versioduo/beat-4/hardware/README.md

# beat-4
🧲 4 Channel Solenoid Controller

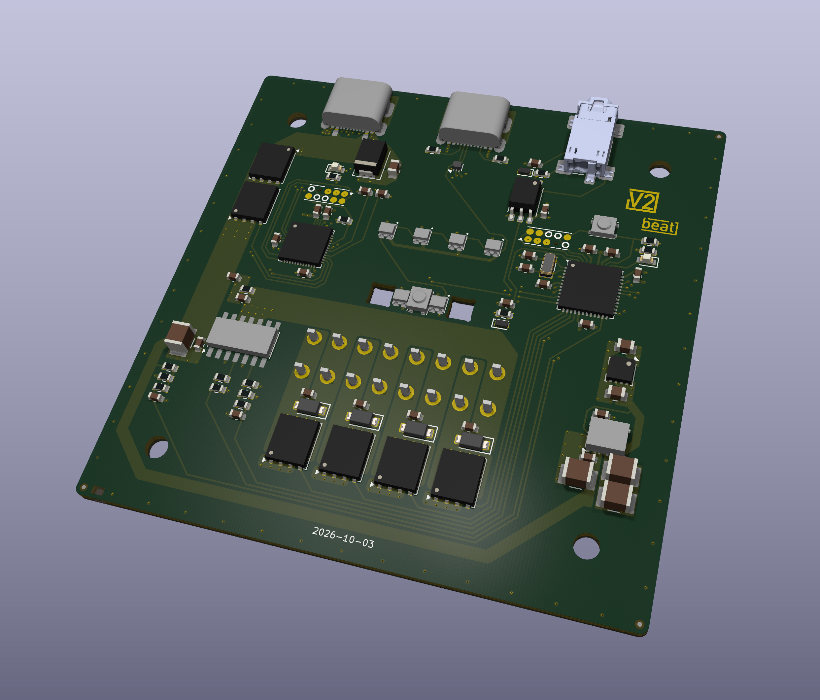
[picture p1: hardware/beat-4-board.png]
board


## Schematic
[PDF](beat-4.pdf)

## Bill Of Materials
[Interactive BOM](https://versioduo.com/view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)
