versioduo/beat-4/hardware/beat-4.pdf

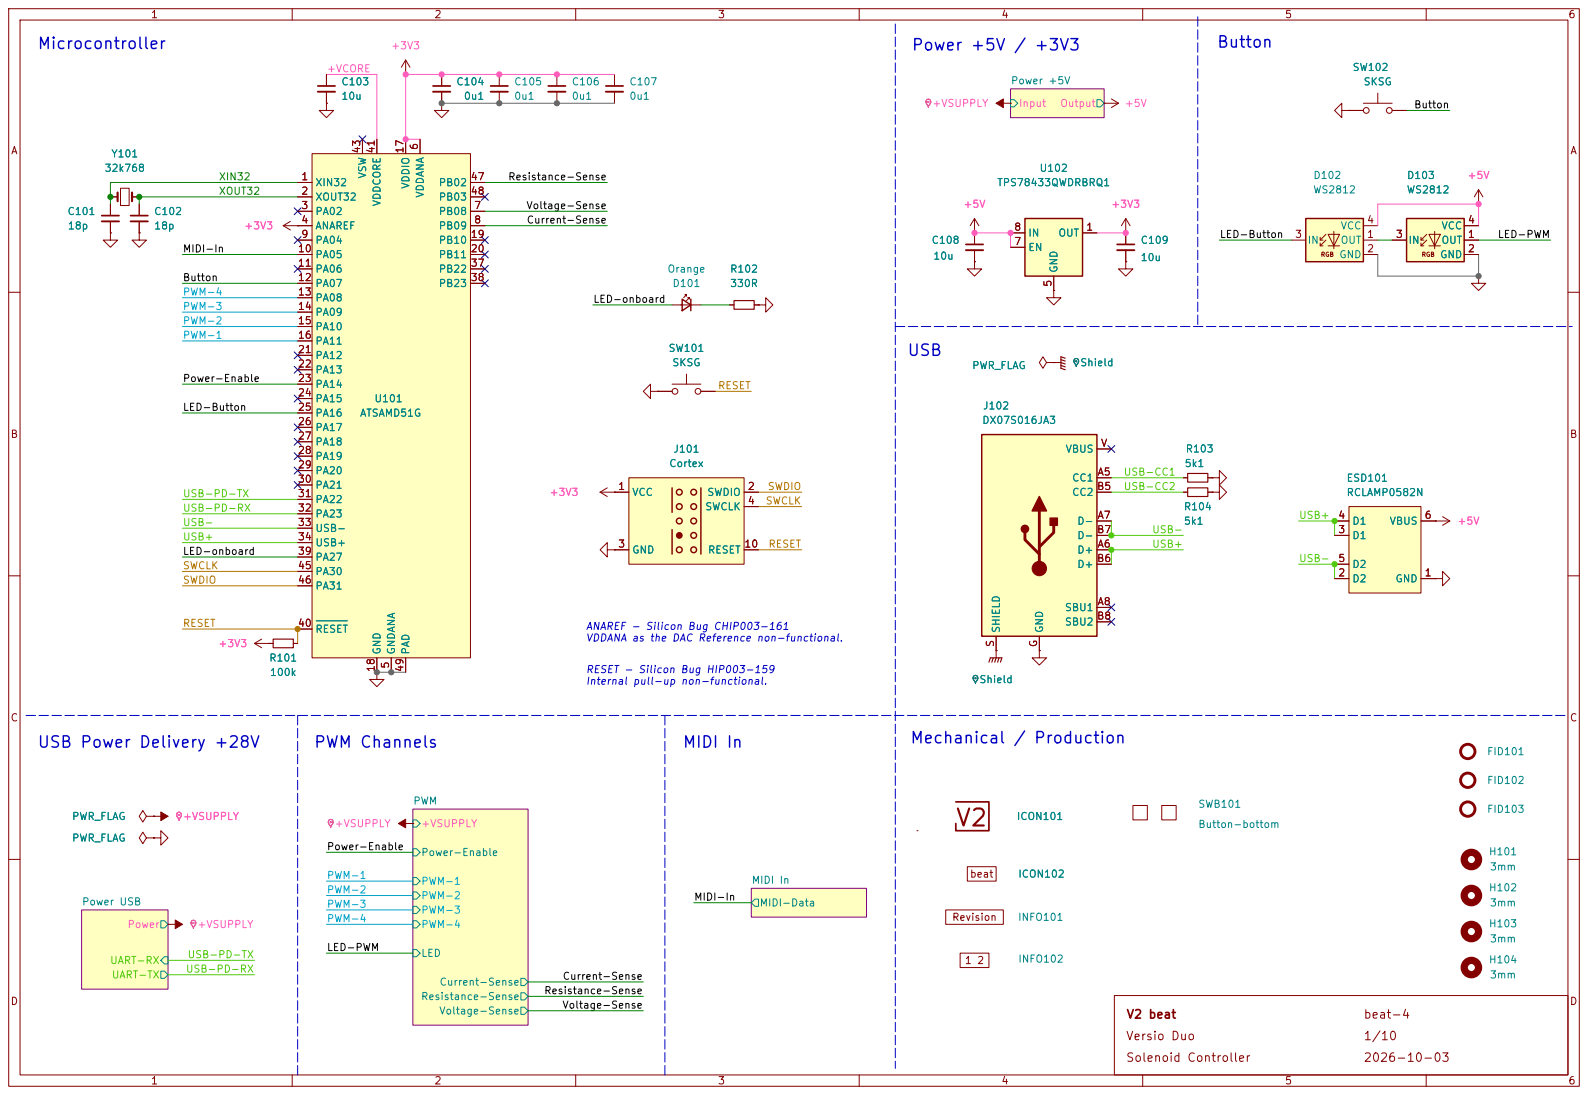
[picture p2: page 1]

FID103 +3V3 C102
LED-Button PWM-1 PWM-4

ANAREF - Silicon Bug CHIP003-161
VDDANA as the DAC Reference non-functional. RESET - Silicon Bug HIP003-159
Voltage-Sense Power-Enable +VSUPPLY PWM

PWM-1 PWM-2 PWM-3 PWM-4 Current-Sense Resistance-Sense

Power UART-RX UART-TX Power USB

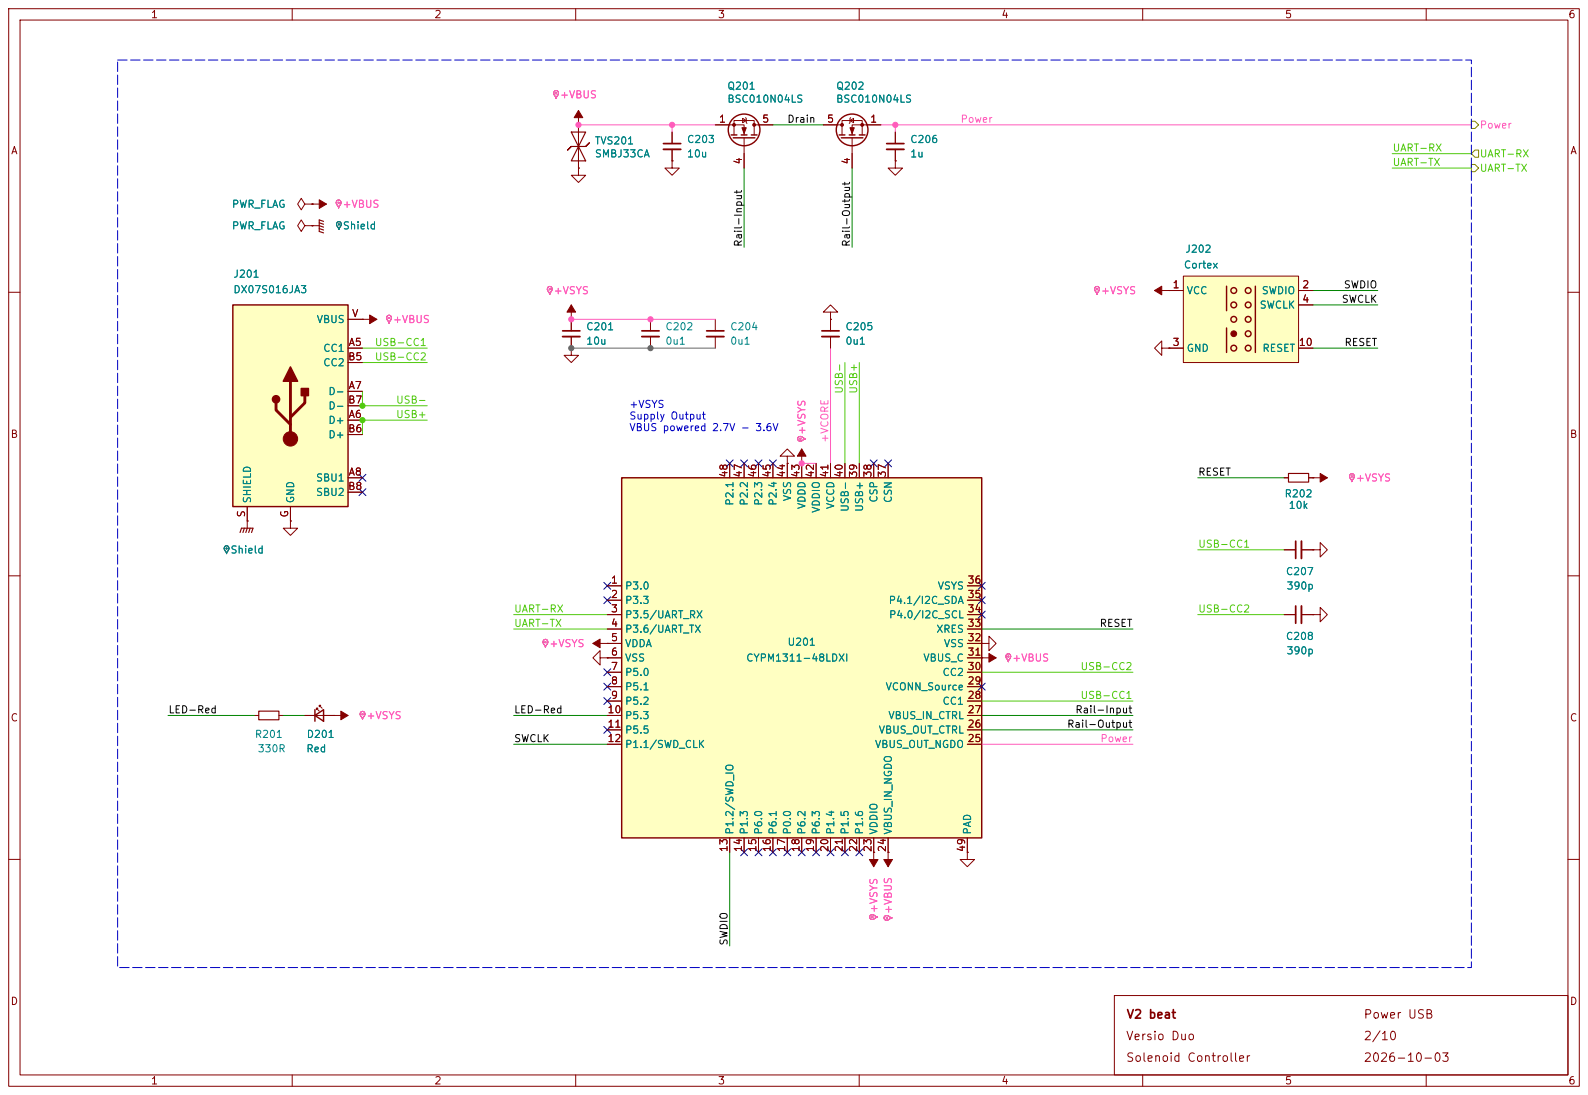
[picture p3: page 2]

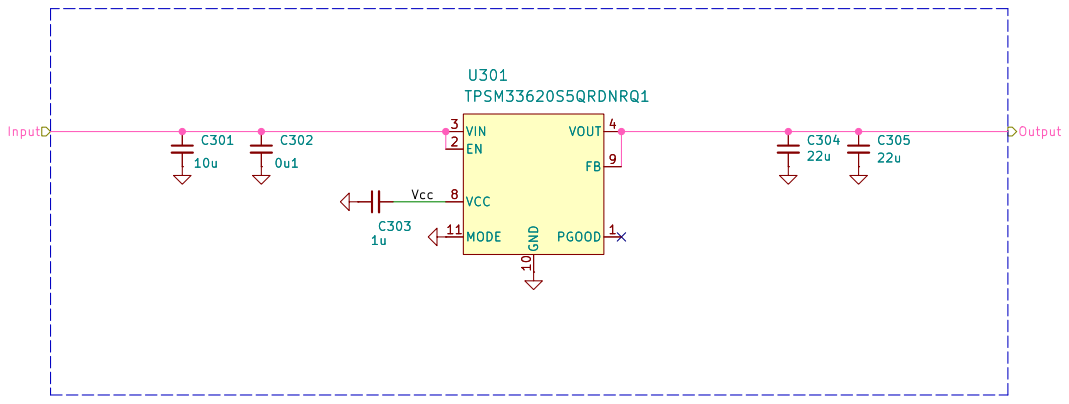
[picture p4: page 3]

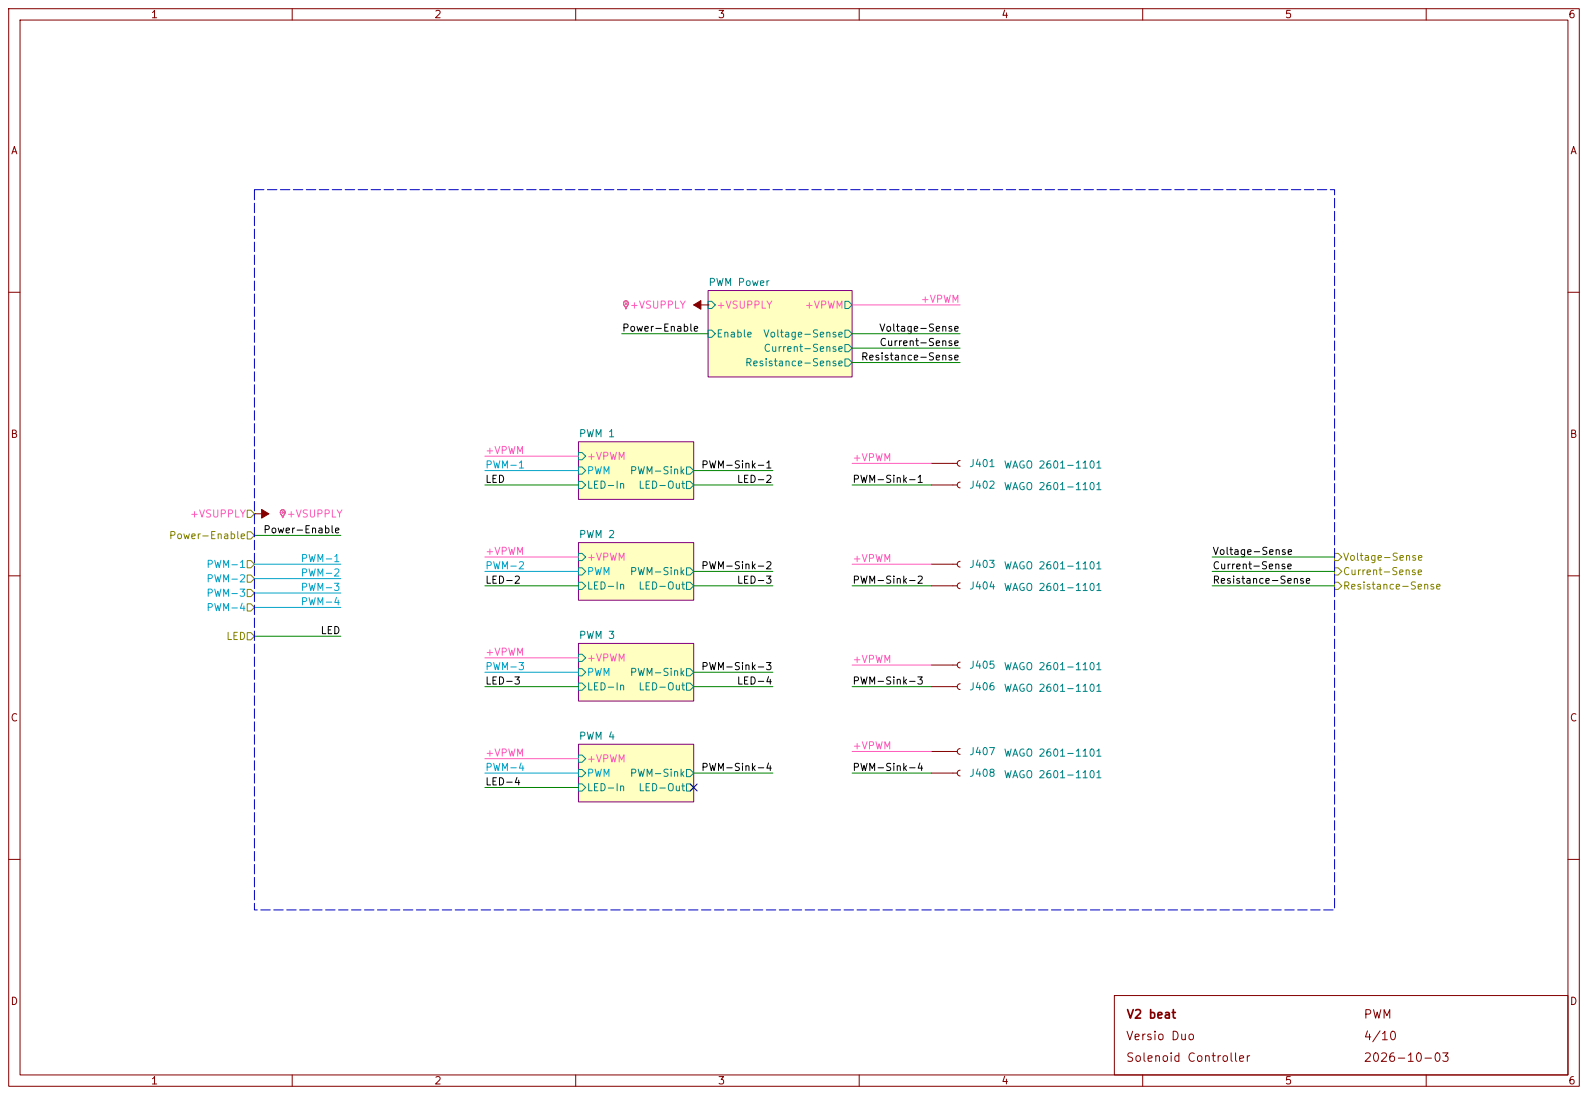
[picture p5: page 4]

Voltage-Sense PWM-Sink-2 Power-Enable

Current-Sense Resistance-Sense

LED-In LED-Out +VPWM
PWM-Sink PWM 2 PWM

Voltage-Sense Current-Sense Resistance-Sense +VPWM +VPWM +VPWM

PWM-Sink PWM 3 PWM

PWM-Sink-2 PWM-Sink-3

PWM

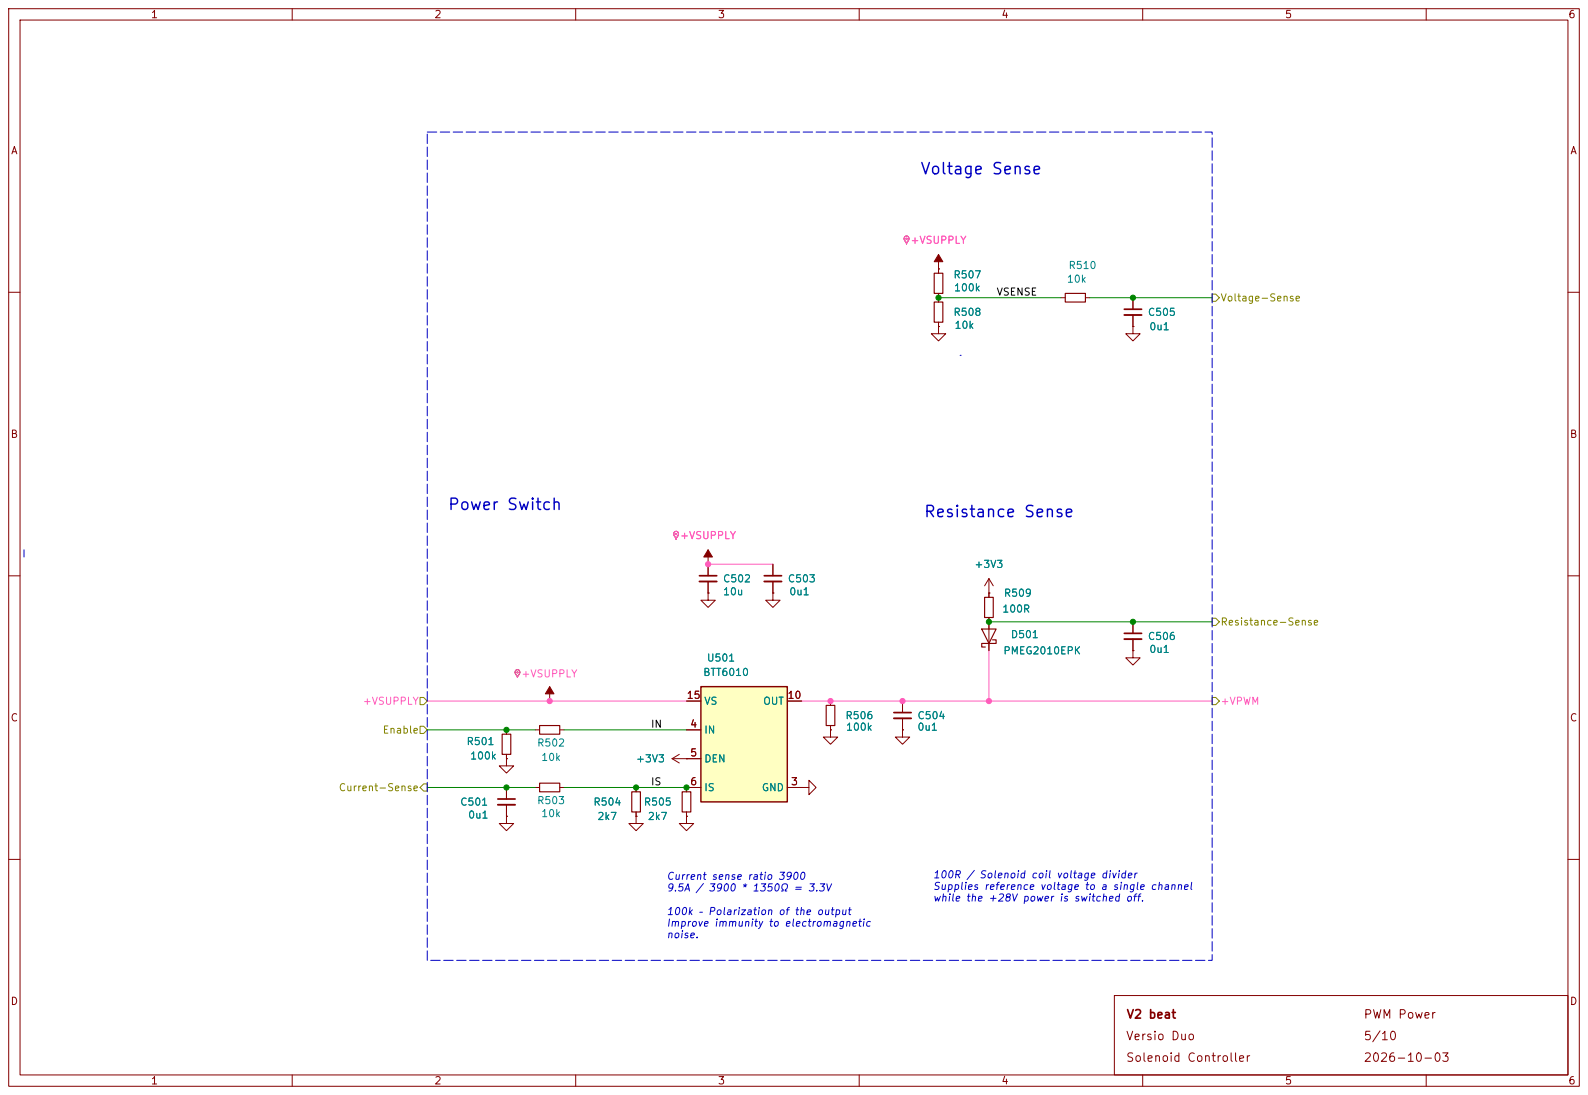
[picture p6: page 5]

Improve immunity to electromagnetic noise. Power Switch

100R / Solenoid coil voltage divider Supplies reference voltage to a single channel while the +28V power is switched off. Resistance Sense

Resistance-Sense Current-Sense Enable +VSUPPLY

Current sense ratio 3900
9.5A / 3900 * 1350Ω = 3.3V 100k – Polarization of the output

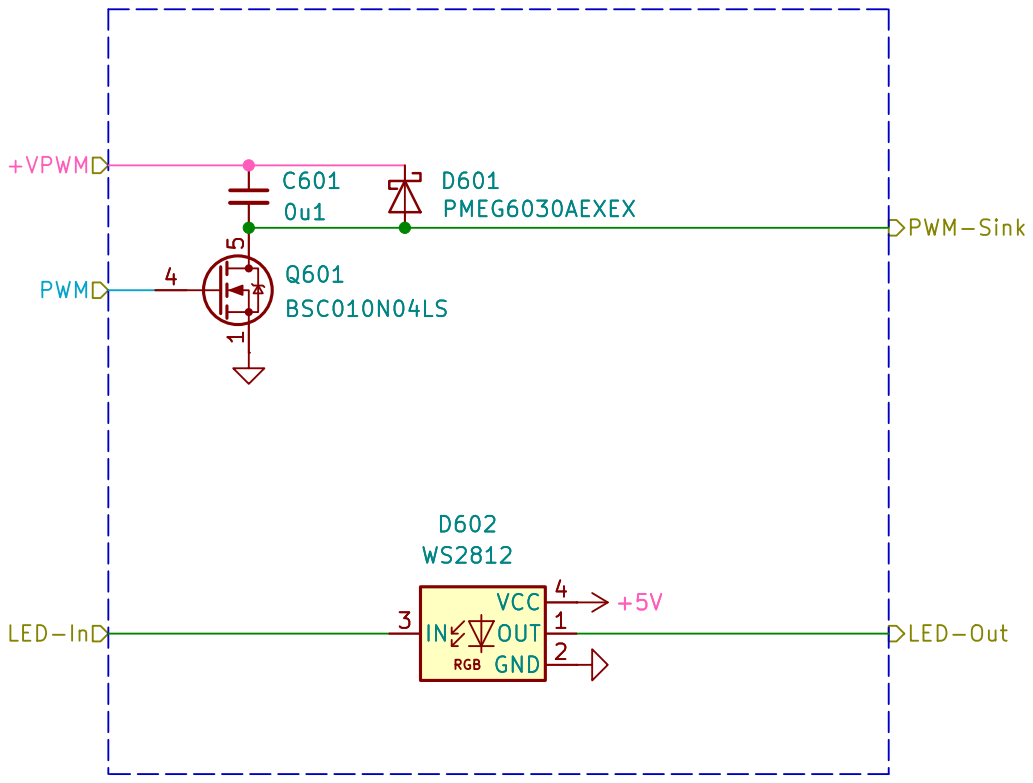
[picture p7: page 6]

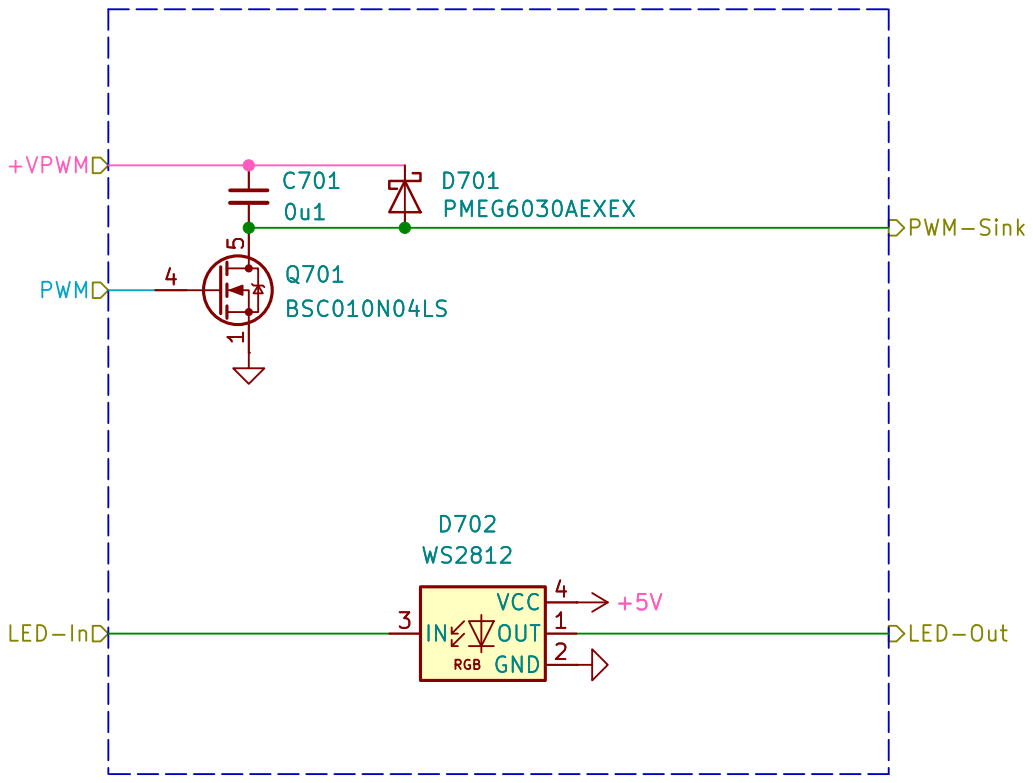
[picture p8: page 7]

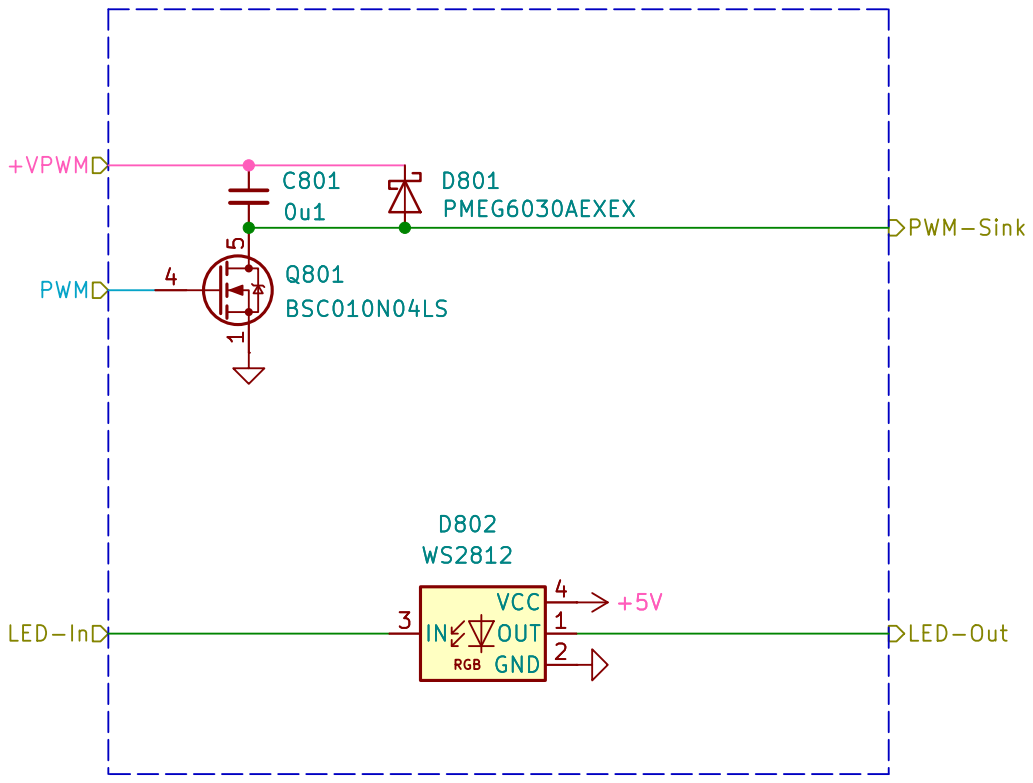
[picture p9: page 8]

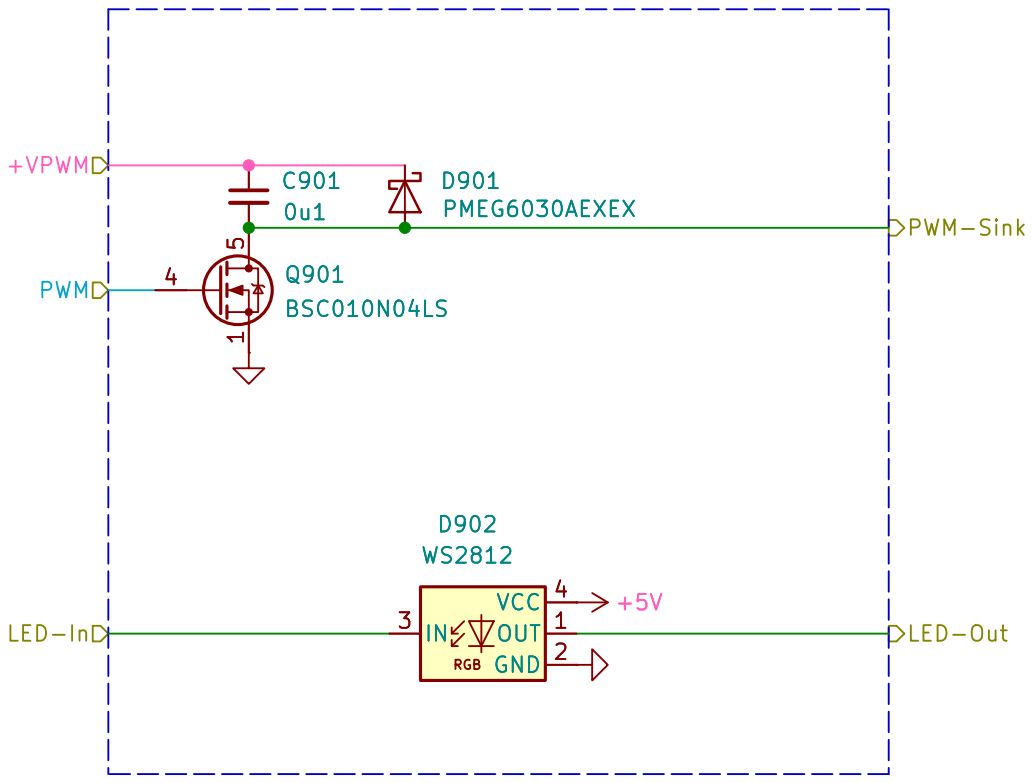
[picture p10: page 9]

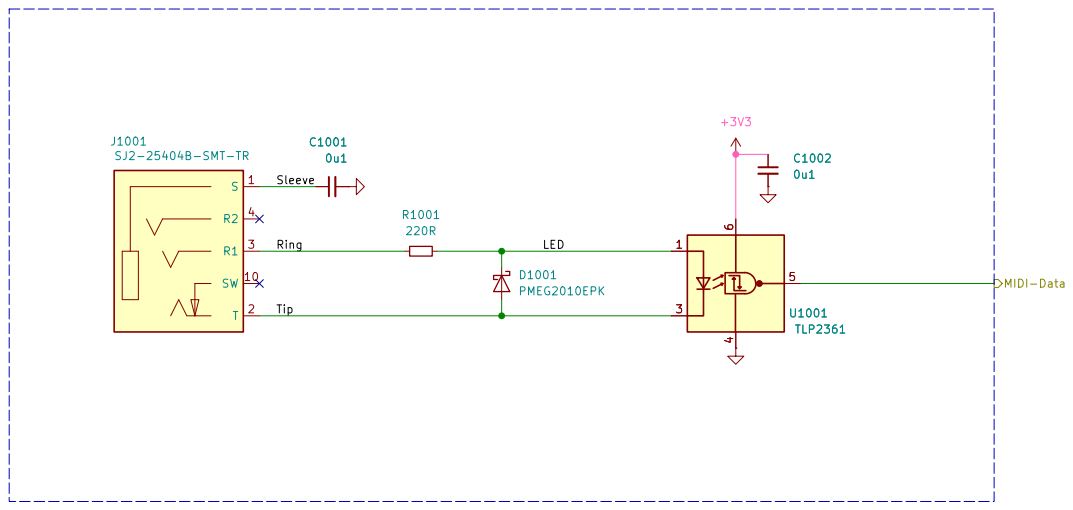
[picture p11: page 10]
