versioduo/beat-4/hardware/beat-4.kicad_pcb

## KiCad design hardware/beat-4.kicad_pcb (2026-10-19)

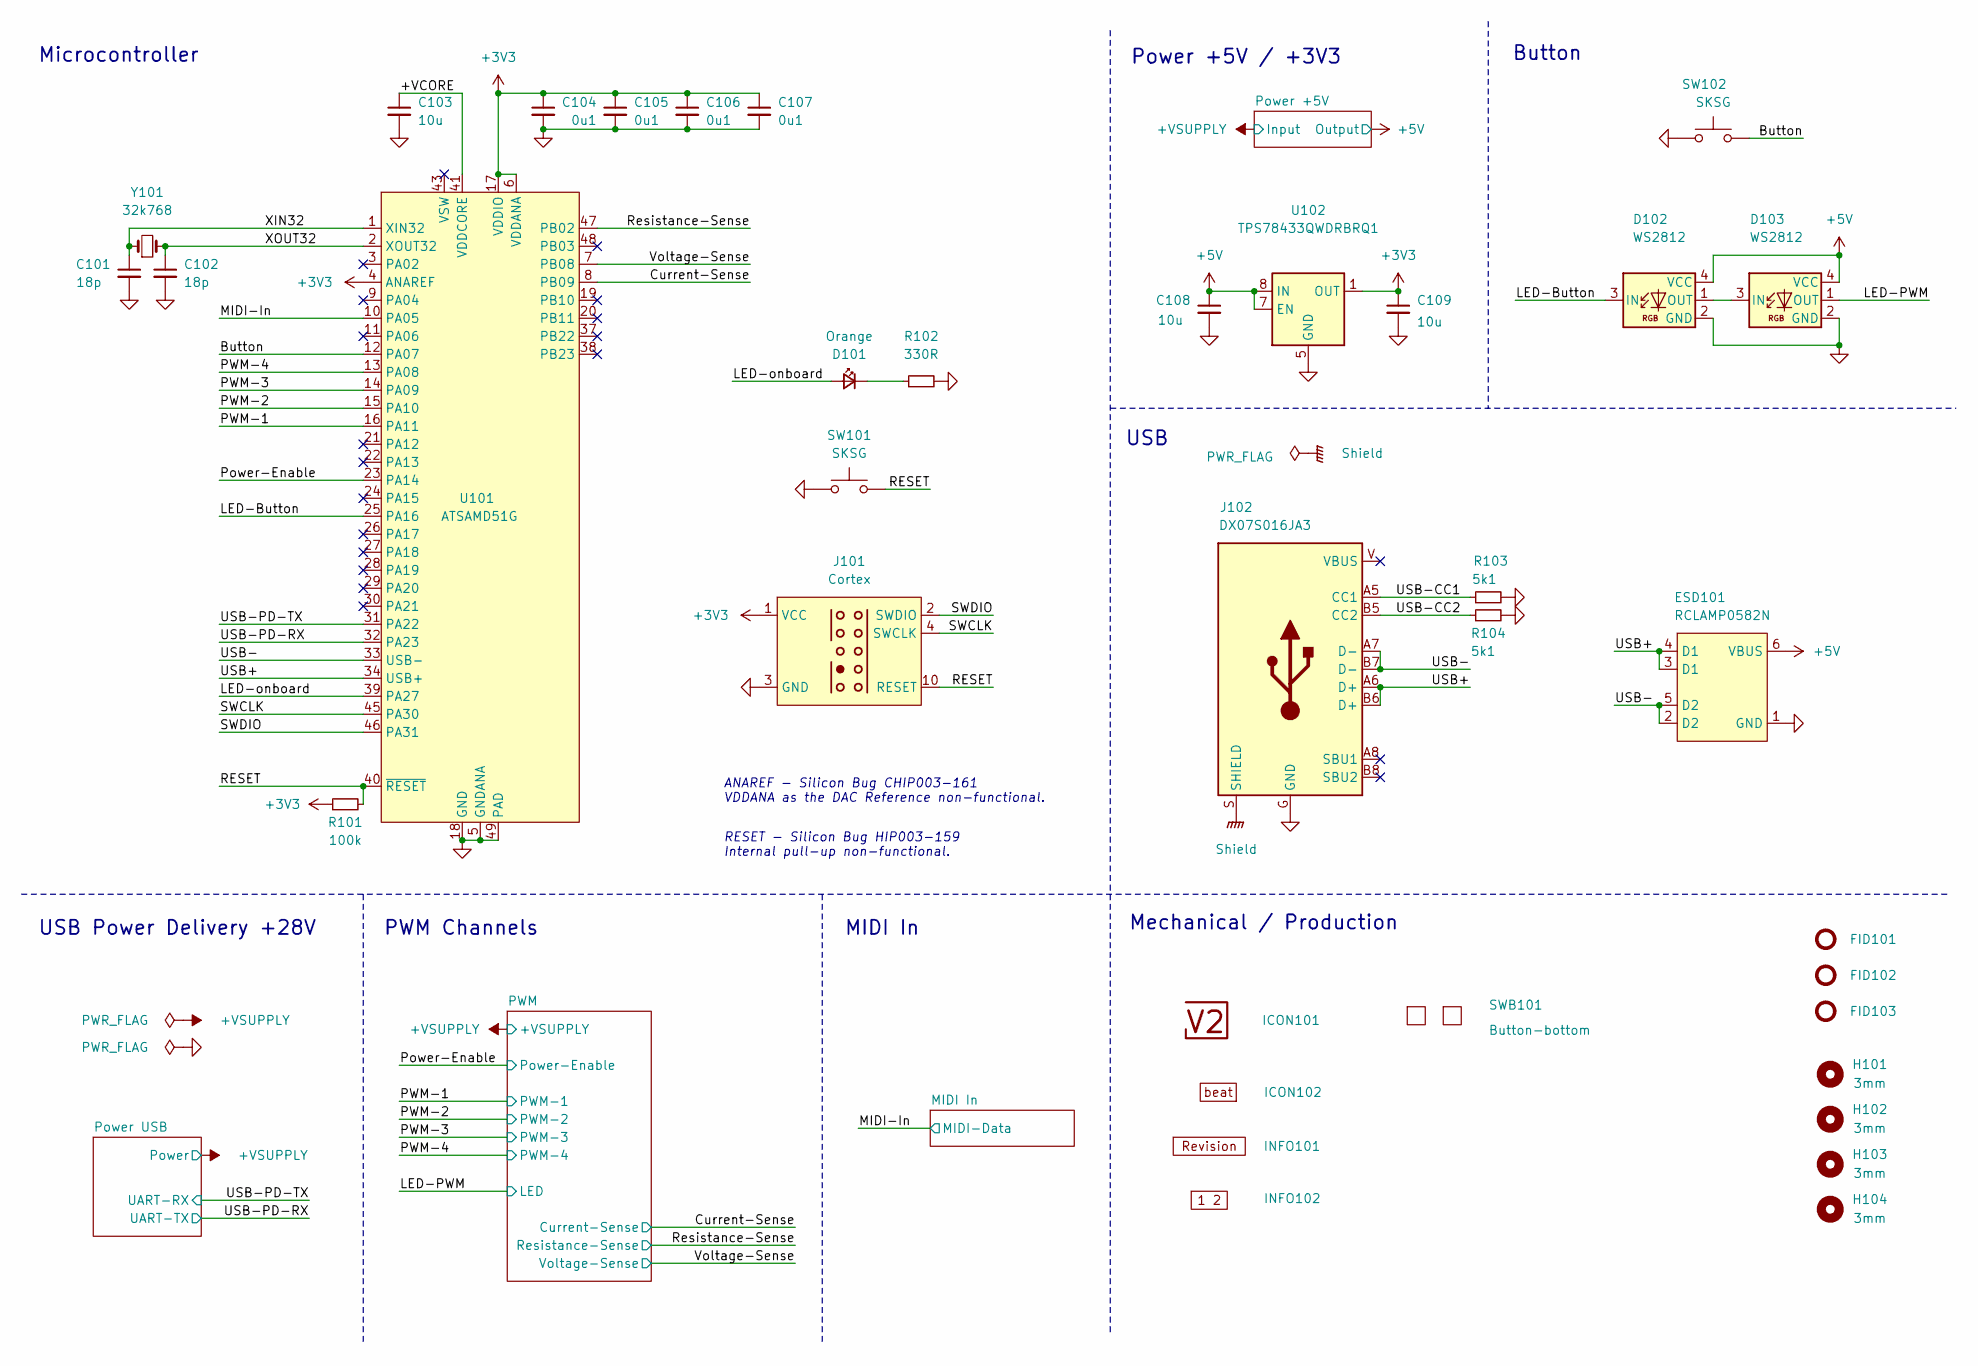
[picture p12: schematic beat-4.kicad_sch, V2 beat]

Parts:
C101, C102: 18p; C_1608; Rating 50V; Mouser 810-CGA3E2C0G1H180J
C103: 10u; C_1608; Rating 10V; Mouser 810-C1608X6S1A106M
C104, C105, C106, C107: 0u1; C_1608; Rating 50V; Mouser 810-CGA3E2X7R1H104MA
C108, C109: 10u; C_2012; Rating 25V; Mouser 810-C2012X5R1E106K
D101: Orange; LED_1608; Rating 605nm; Mouser 755-SML-D12D1WT86
D102, D103: WS2812; WS2812-2020; Rating 15mA; LCSC C965555
ESD101: RCLAMP0582N; SLP1210N6; Rating 20kV; Mouser 947-RCLAMP0582N.TCT
FID101, FID102, FID103: Fiducial_Paste; Fiducial_0.5mm_Mask1mm_Paste
H101, H102, H103, H104: 3mm; MountingHole_3mm
ICON101: V2-logo; Logo_Small
ICON102: Board_axis; Board_beat_Small
INFO101: Revision
INFO102: Layer_Numbers-4
J101: Cortex
J102: DX07S016JA3; JAE_DX07S016JA3; Rating USB2.0; Mouser 656-DX07S016JA3R1500
R101: 100k; R_1608; Rating 100mW; Mouser 71-CRCW0603100KFKEAC
R102: 330R; R_1608; Rating 100mW; Mouser 71-CRCW0603330RFKEAC
R103, R104: 5k1; R_1608; Rating 100mW; Mouser 71-CRCW06035K10FKEAC
SW101, SW102: SKSG; Rating 1.6N; Mouser 688-SKSGACE010
SWB101: Button-bottom; PCB_Button-bottom
U101: ATSAMD51G; QFN-48-1EP_7x7mm_P0.5mm_EP5.45x5.45mm_ThermalVias; Rating Cortex-M4F; Mouser 556-ATSAMD51G19AMU
U102: TPS78433QWDRBRQ1; VSON-8-1_3x3mm_P0.65_EP1.65x2.4mm; Rating 300mA; Mouser 595-TPS78433QWDRBRQ1
Y101: 32k768; Crystal_SMD_3215-2Pin_3.2x1.5mm; Rating 10ppm; Mouser 815-ABS0716632.768KT

Connections:
+3V3: C104.1, C105.1, C106.1, C107.1, C109.1, J101.1 (VCC), R101.1, U101.4 (ANAREF), U101.6 (VDDANA), U101.17 (VDDIO), U101.36 (VDDIO), U101.44 (VDDIO), U102.1 (OUT); also elsewhere on the board
+5V: C108.1, D102.4 (VCC), D103.4 (VCC), ESD101.6 (VBUS), U102.6 (EN), U102.7 (EN), U102.8 (IN); also elsewhere on the board
/+VCORE: C103.1, U101.41 (VDDCORE)
/Button: SW102.2, U101.12 (PA07)
/Current-Sense: U101.8 (PB09); also elsewhere on the board
/LED-Button: D102.3 (IN), U101.25 (PA16)
/LED-PWM: D103.1 (OUT); also elsewhere on the board
/LED-onboard: D101.2 (A), U101.39 (PA27)
/MIDI-In: U101.10 (PA05); also elsewhere on the board
/PWM-1: U101.16 (PA11); also elsewhere on the board
/PWM-2: U101.15 (PA10); also elsewhere on the board
/PWM-3: U101.14 (PA09); also elsewhere on the board
/PWM-4: U101.13 (PA08); also elsewhere on the board
/Power-Enable: U101.23 (PA14); also elsewhere on the board
/RESET: J101.10 (RESET), R101.2, SW101.2, U101.40 (~RESET)
/Resistance-Sense: U101.47 (PB02); also elsewhere on the board
/SWCLK: J101.4 (SWCLK), U101.45 (PA30)
/SWDIO: J101.2 (SWDIO), U101.46 (PA31)
/Shield: J102.S (SHIELD)
/USB+: ESD101.3 (D1), ESD101.4 (D1), J102.A6 (D+), J102.B6 (D+), U101.34 (USB+)
/USB-: ESD101.2 (D2), ESD101.5 (D2), J102.A7 (D-), J102.B7 (D-), U101.33 (USB-)
/USB-CC1: J102.A5 (CC1), R103.1
/USB-CC2: J102.B5 (CC2), R104.1
/USB-PD-RX: U101.32 (PA23); also elsewhere on the board
/USB-PD-TX: U101.31 (PA22); also elsewhere on the board
/Voltage-Sense: U101.7 (PB08); also elsewhere on the board
/XIN32: C101.1, U101.1 (XIN32), Y101.1
/XOUT32: C102.1, U101.2 (XOUT32), Y101.2
GND: C101.2, C102.2, C103.2, C104.2, C105.2, C106.2, C107.2, C108.2, C109.2, D102.2 (GND), D103.2 (GND), ESD101.1 (GND), J101.3 (GND), J101.5 (GND), J102.G (GND), R102.2, R103.2, R104.2, SW101.1, SW102.1, U101.5 (GNDANA), U101.18 (GND), U101.35 (GND), U101.42 (GND), U101.49 (PAD), U102.5 (GND), U102.9 (GND); also elsewhere on the board
unnamed: D101.1 (K), R102.1
unnamed: D102.1 (OUT), D103.3 (IN)

Notes on the sheet:
ANAREF -  Silicon Bug CHIP003-161 VDDANA as the DAC Reference non-functional.
PWM Channels
RESET -  Silicon Bug HIP003-159 Internal pull-up non-functional.
Button
Power +5V / +3V3
Mechanical / Production
Microcontroller
MIDI In
USB
USB Power Delivery +28V

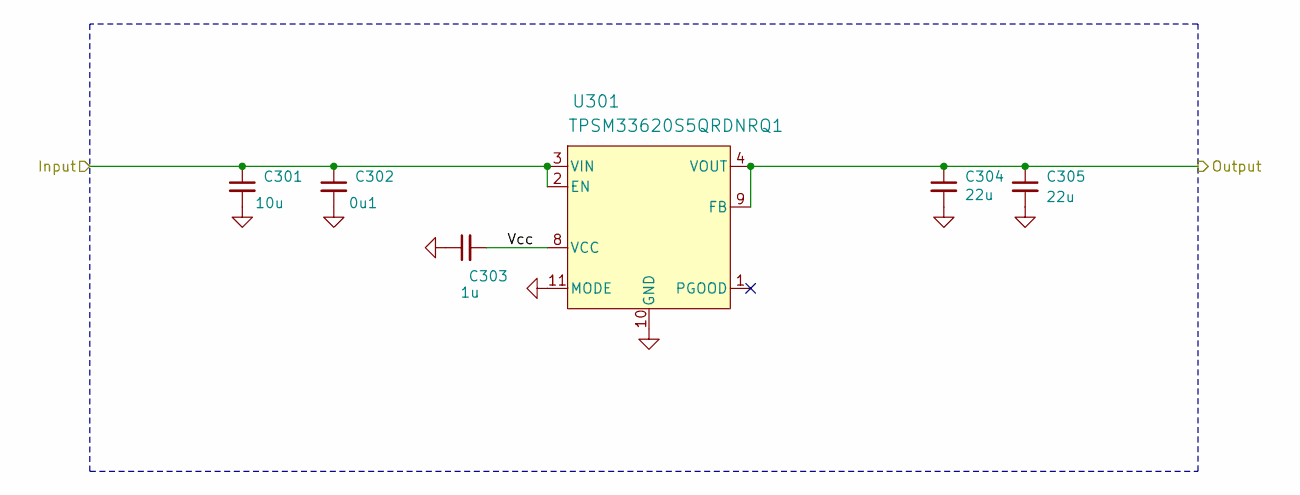
[picture p13: schematic Power-DCDC.kicad_sch, V2 beat]

Parts:
C301: 10u; C_3225; Rating 50V; Mouser 810-CNC6P1X7R1H106K2
C302: 0u1; C_1608; Rating 50V; Mouser 810-CGA3E2X7R1H104MA
C303: 1u; C_1608; Rating 50V; Mouser 810-CGA3E3X7R1H105K0
C304, C305: 22u; C_3225; Rating 25V; Mouser 810-CGA6P3X7R1E226M5
U301: TPSM33620S5QRDNRQ1; QFN-11; Rating 2A; Mouser 595-SM33620S5QRDNRQ1

Connections:
+5V: C304.1, C305.1, U301.4 (VOUT), U301.9 (FB); also elsewhere on the board
/+VSUPPLY: C301.1, C302.1, U301.2 (EN), U301.3 (VIN); also elsewhere on the board
/Power +5V/Vcc: C303.2, U301.8 (VCC)
GND: C301.2, C302.2, C303.1, C304.2, C305.2, U301.10 (GND), U301.11 (MODE); also elsewhere on the board

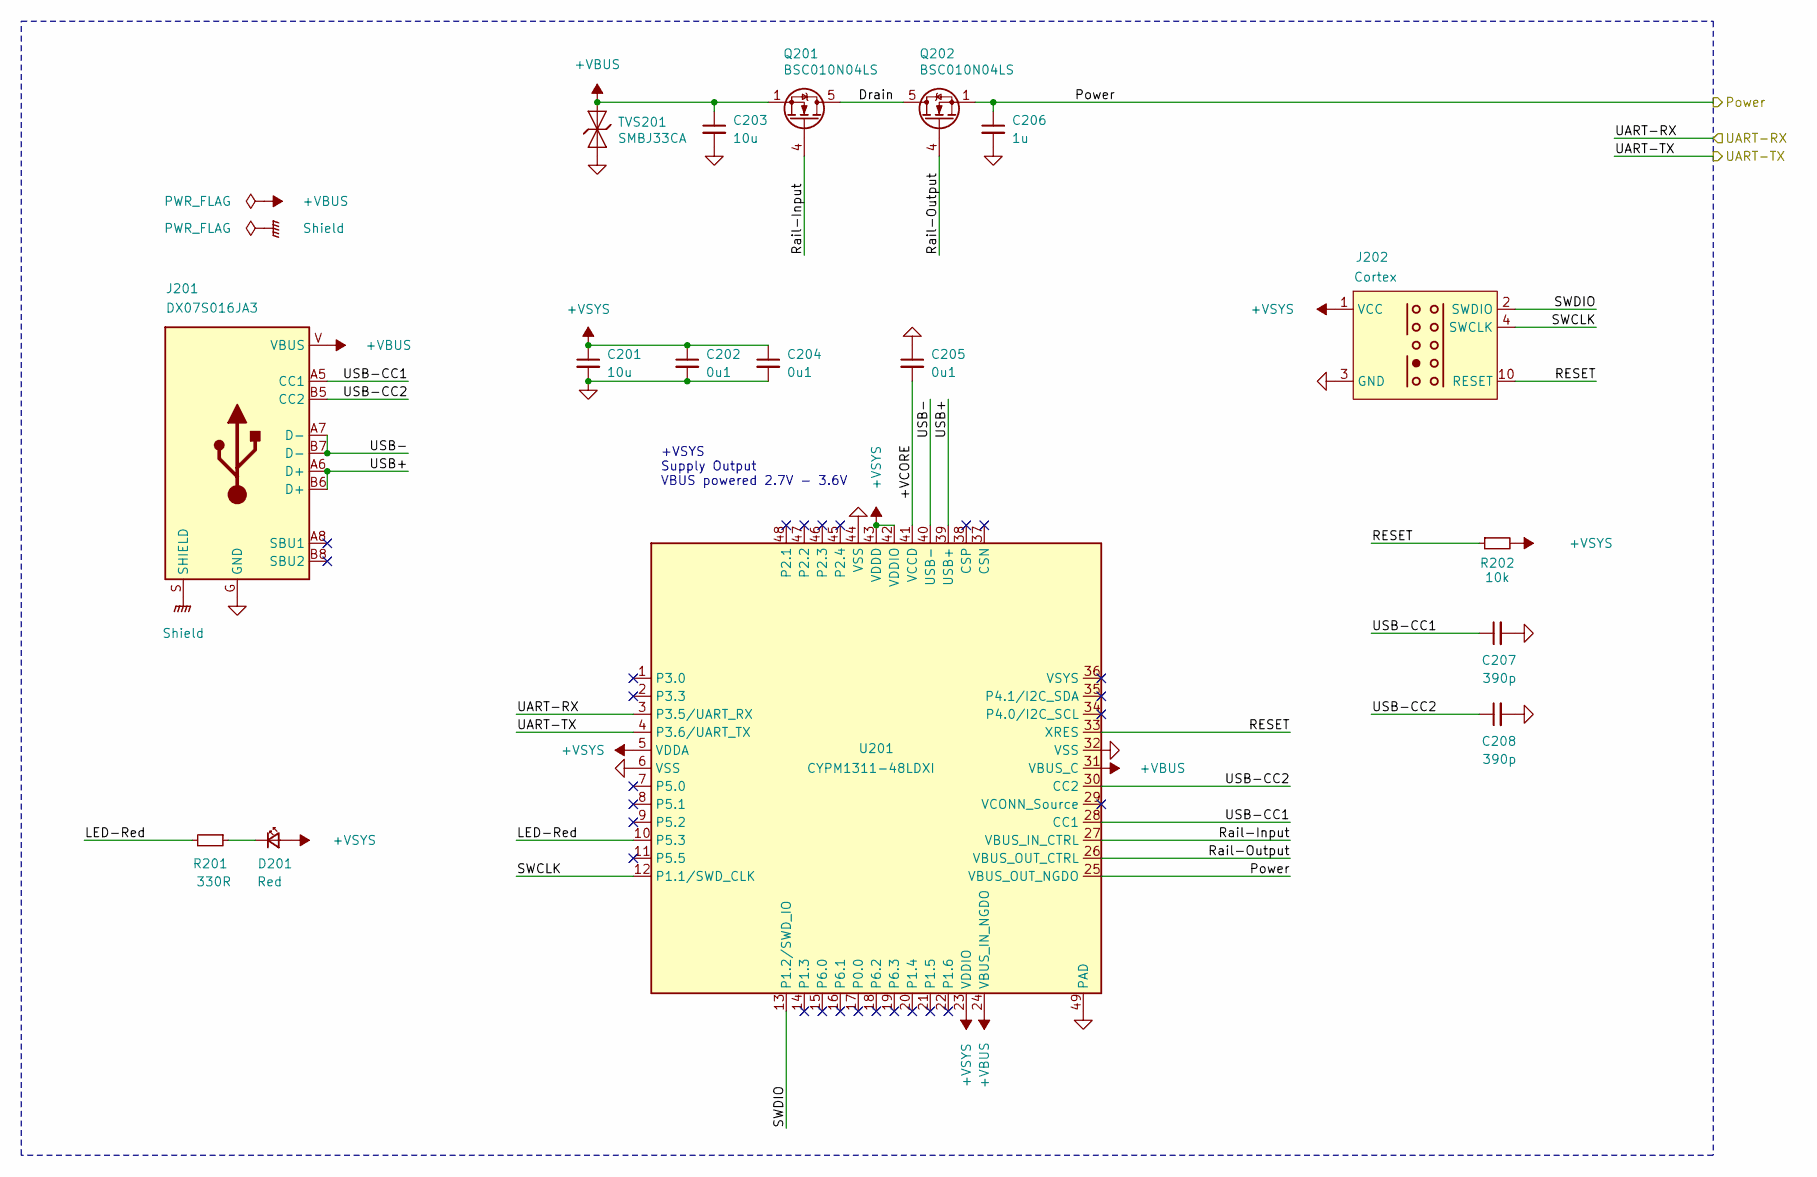
[picture p14: schematic Power-USB.kicad_sch, V2 beat]

Parts:
C201: 10u; C_1608; Rating 10V; Mouser 810-C1608X6S1A106M
C202, C204, C205: 0u1; C_1608; Rating 50V; Mouser 810-CGA3E2X7R1H104MA
C203: 10u; C_2012; Rating 25V; Mouser 810-C2012X5R1E106K
C206: 1u; C_1608; Rating 50V; Mouser 810-CGA3E3X7R1H105K0
C207, C208: 390p; C_1608; Rating 50V; Mouser 810-CGA3E2C0G1H391J
D201: Red; LED_1608; Rating 630nm; Mouser 755-SML-D12V1WT86
J201: DX07S016JA3; JAE_DX07S016JA3-PD; Rating USB2.0; Mouser 656-DX07S016JA3R1500
J202: Cortex
Q201, Q202: BSC010N04LS; TDSON-8-FL; Rating 40V; Mouser 726-BSC010N04LS
R201: 330R; R_1608; Rating 100mW; Mouser 71-CRCW0603330RFKEAC
R202: 10k; R_1608; Rating 100mW; Mouser 71-CRCW060310K0FKEAC
TVS201: SMBJ33CA; D_SMB; Rating 33V; Mouser 652-SMBJ33CA-Q
U201: CYPM1311-48LDXI; QFN-48-1EP_6x6mm_P0.4mm_EP4.6x4.6mm; Rating 28V; Mouser 727-CYPM1311-48LDXI

Connections:
/+VSUPPLY: C206.1, Q202.1 (S), U201.25 (VBUS_OUT_NGDO); also elsewhere on the board
/Power USB/+VBUS: C203.1, J201.V (VBUS), Q201.1 (S), TVS201.2 (A), U201.24 (VBUS_IN_NGDO), U201.31 (VBUS_C)
/Power USB/+VCORE: C205.2, U201.41 (VCCD)
/Power USB/+VSYS: C201.1, C202.1, C204.1, D201.2 (A), J202.1 (VCC), R202.2, U201.5 (VDDA), U201.23 (VDDIO), U201.42 (VDDIO), U201.43 (VDDD)
/Power USB/Drain: Q201.5 (D), Q202.5 (D)
/Power USB/LED-Red: R201.2, U201.10 (P5.3)
/Power USB/RESET: J202.10 (RESET), R202.1, U201.33 (XRES)
/Power USB/Rail-Input: Q201.4 (G), U201.27 (VBUS_IN_CTRL)
/Power USB/Rail-Output: Q202.4 (G), U201.26 (VBUS_OUT_CTRL)
/Power USB/SWCLK: J202.4 (SWCLK), U201.12 (P1.1/SWD_CLK)
/Power USB/SWDIO: J202.2 (SWDIO), U201.13 (P1.2/SWD_IO)
/Power USB/Shield: J201.S (SHIELD)
/Power USB/USB+: J201.A6 (D+), J201.B6 (D+), U201.39 (USB+)
/Power USB/USB-: J201.A7 (D-), J201.B7 (D-), U201.40 (USB-)
/Power USB/USB-CC1: C207.1, J201.A5 (CC1), U201.28 (CC1)
/Power USB/USB-CC2: C208.1, J201.B5 (CC2), U201.30 (CC2)
/USB-PD-RX: U201.4 (P3.6/UART_TX); also elsewhere on the board
/USB-PD-TX: U201.3 (P3.5/UART_RX); also elsewhere on the board
GND: C201.2, C202.2, C203.2, C204.2, C205.1, C206.2, C207.2, C208.2, J201.G (GND), J202.3 (GND), J202.5 (GND), TVS201.1 (K), U201.6 (VSS), U201.32 (VSS), U201.44 (VSS), U201.49 (PAD); also elsewhere on the board
unnamed: D201.1 (K), R201.1

Notes on the sheet:
+VSYS Supply Output VBUS powered 2.7V - 3.6V

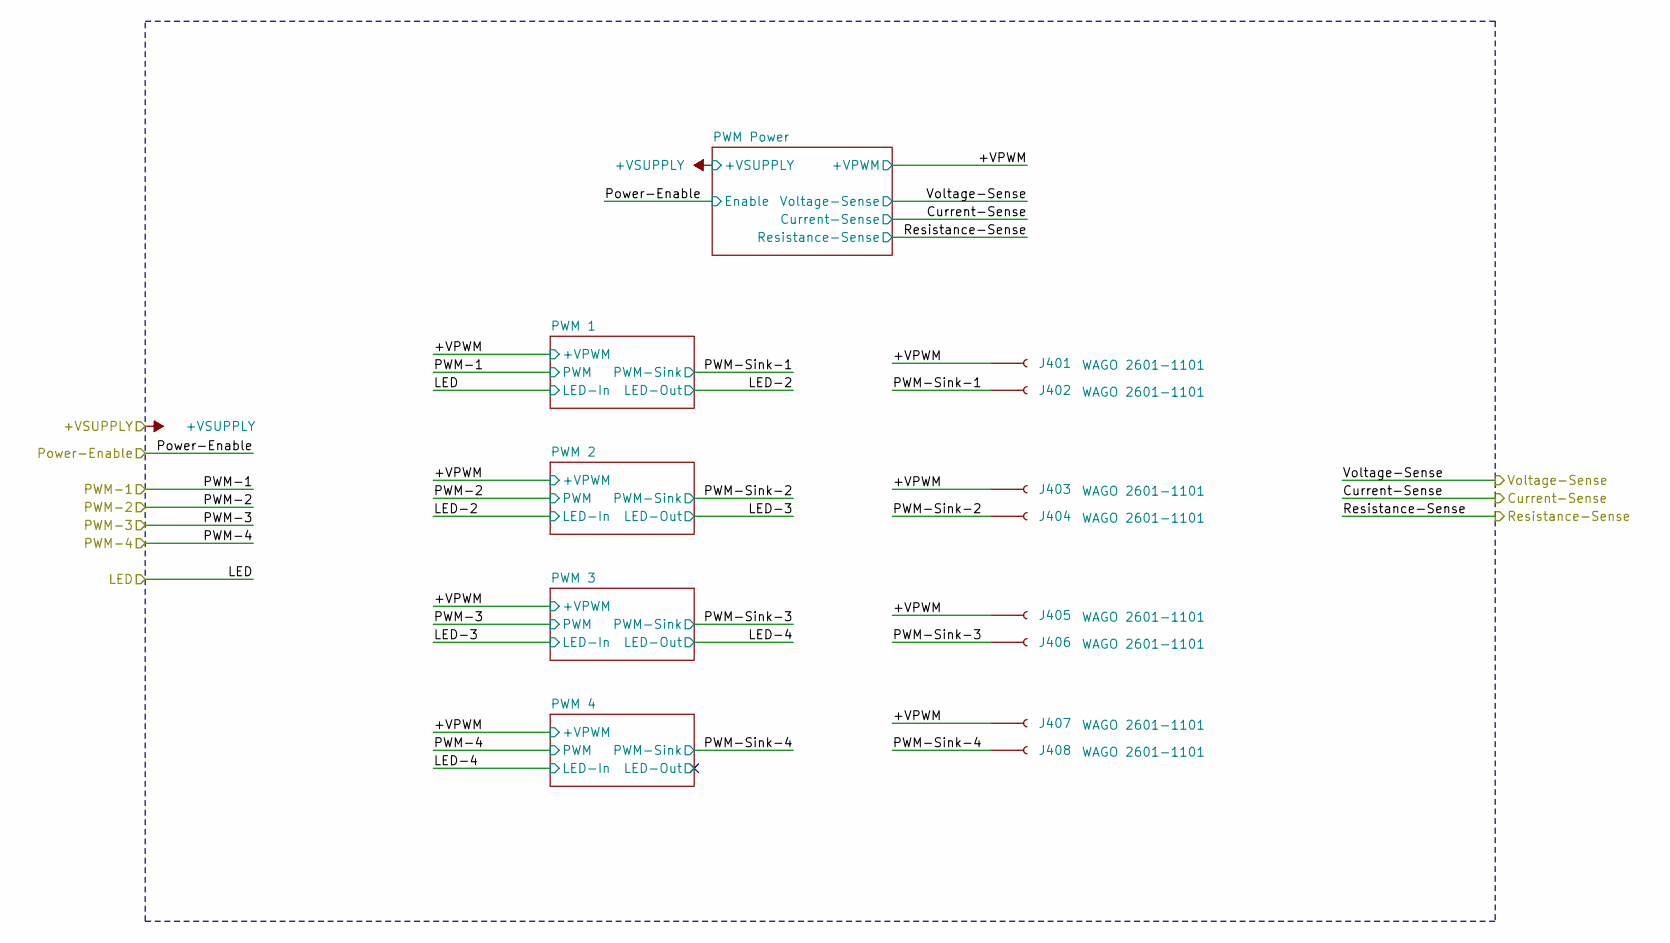
[picture p15: schematic PWM.kicad_sch, V2 beat]

Parts:
J401, J402, J403, J404, J405, J406, J407, J408: WAGO 2601-1101; 2601-1101; Rating 17.5A

Connections:
/PWM/+VPWM: J401.1, J403.1, J405.1, J407.1; also elsewhere on the board
/PWM/PWM-Sink-1: J402.1; also elsewhere on the board
/PWM/PWM-Sink-2: J404.1; also elsewhere on the board
/PWM/PWM-Sink-3: J406.1; also elsewhere on the board
/PWM/PWM-Sink-4: J408.1; also elsewhere on the board

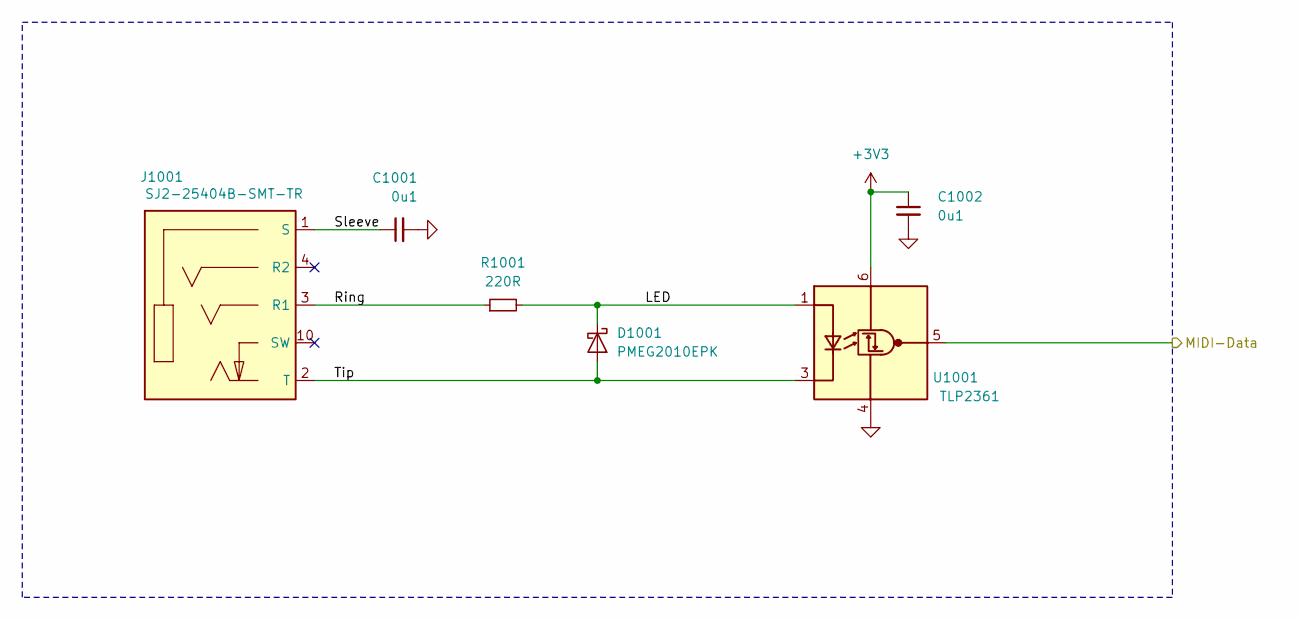
[picture p16: schematic MIDI-In.kicad_sch, V2 beat]

Parts:
C1001, C1002: 0u1; C_1608; Rating 50V; Mouser 810-CGA3E2X7R1H104MA
D1001: PMEG2010EPK; D_SOD-1608; Rating 20V; Mouser 771-PMEG2010EPK
J1001: SJ2-25404B-SMT-TR; CUI_SJ2-25404B-SMT-TR; Rating 2.5mm; Mouser 490-SJ2-25404BSMT-TR
R1001: 220R; R_1608; Rating 333mW; Mouser 667-ERJ-PA3F2200V
U1001: TLP2361; SO-5-6_4.55x3.7mm_P1.27mm; Rating 15Mbps; Mouser 757-TLP2361TPRE

Connections:
+3V3: C1002.1, U1001.6 (VDD); also elsewhere on the board
/MIDI In/LED: D1001.1 (K), R1001.2, U1001.1 (A)
/MIDI In/Ring: J1001.3 (R1), R1001.1
/MIDI In/Sleeve: C1001.1, J1001.1 (S)
/MIDI In/Tip: D1001.2 (A), J1001.2 (T), U1001.3 (K)
/MIDI-In: U1001.5 (VO); also elsewhere on the board
GND: C1001.2, C1002.2, U1001.4 (GND); also elsewhere on the board

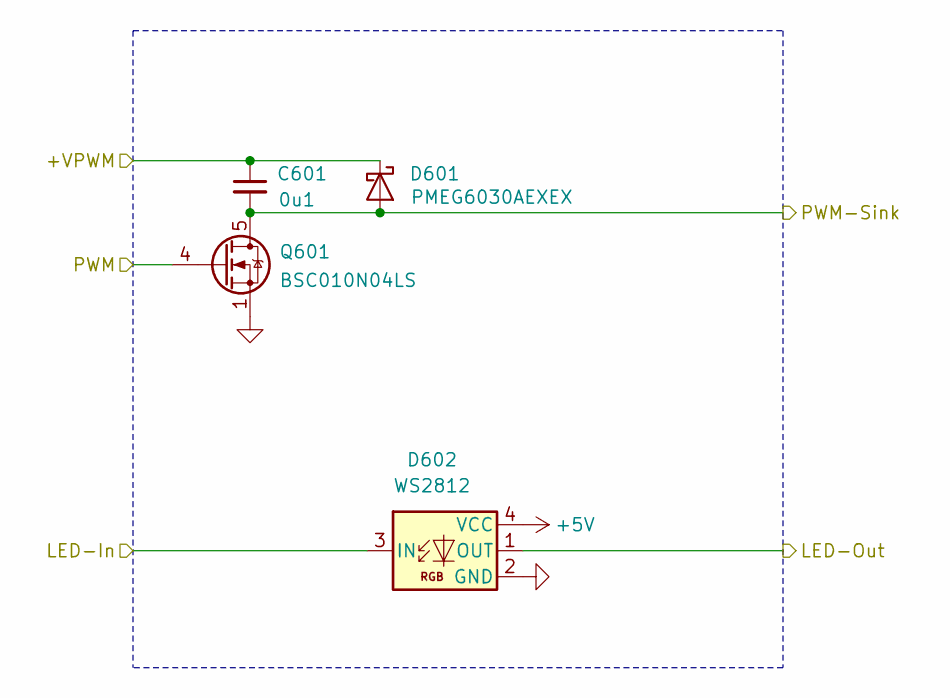
[picture p17: schematic PWM-Channel.kicad_sch, V2 beat]

Parts:
C601: 0u1; C_1608; Rating 50V; Mouser 810-CGA3E2X7R1H104MA
D601: PMEG6030AEXEX; D_SOD-123HP; Rating 60V; Mouser 771-PMEG6030AEXEX
D602: WS2812; WS2812-2020; Rating 15mA; LCSC C965555
Q601: BSC010N04LS; TDSON-8-FL; Rating 40V; Mouser 726-BSC010N04LS

Connections:
+5V: D602.4 (VCC); also elsewhere on the board
/LED-PWM: D602.3 (IN); also elsewhere on the board
/PWM-1: Q601.4 (G); also elsewhere on the board
/PWM/+VPWM: C601.1, D601.1 (K); also elsewhere on the board
/PWM/LED-2: D602.1 (OUT); also elsewhere on the board
/PWM/PWM-Sink-1: C601.2, D601.2 (A), Q601.5 (D); also elsewhere on the board
GND: D602.2 (GND), Q601.1 (S); also elsewhere on the board

Parts of its further copies:
C701, C801, C901: 0u1; C_1608; Rating 50V; Mouser 810-CGA3E2X7R1H104MA
D701, D801, D901: PMEG6030AEXEX; D_SOD-123HP; Rating 60V; Mouser 771-PMEG6030AEXEX
D702, D802, D902: WS2812; WS2812-2020; Rating 15mA; LCSC C965555
Q701, Q801, Q901: BSC010N04LS; TDSON-8-FL; Rating 40V; Mouser 726-BSC010N04LS

Connections of its further copies:
+5V: D702.4 (VCC), D802.4 (VCC), D902.4 (VCC); also elsewhere on the board
/PWM-2: Q701.4 (G); also elsewhere on the board
/PWM-3: Q801.4 (G); also elsewhere on the board
/PWM-4: Q901.4 (G); also elsewhere on the board
/PWM/+VPWM: C701.1, C801.1, C901.1, D701.1 (K), D801.1 (K), D901.1 (K); also elsewhere on the board
/PWM/LED-2: D702.3 (IN); also elsewhere on the board
/PWM/LED-3: D702.1 (OUT), D802.3 (IN)
/PWM/LED-4: D802.1 (OUT), D902.3 (IN)
/PWM/PWM 4/LED-Out: D902.1 (OUT)
/PWM/PWM-Sink-2: C701.2, D701.2 (A), Q701.5 (D); also elsewhere on the board
/PWM/PWM-Sink-3: C801.2, D801.2 (A), Q801.5 (D); also elsewhere on the board
/PWM/PWM-Sink-4: C901.2, D901.2 (A), Q901.5 (D); also elsewhere on the board
GND: D702.2 (GND), D802.2 (GND), D902.2 (GND), Q701.1 (S), Q801.1 (S), Q901.1 (S); also elsewhere on the board

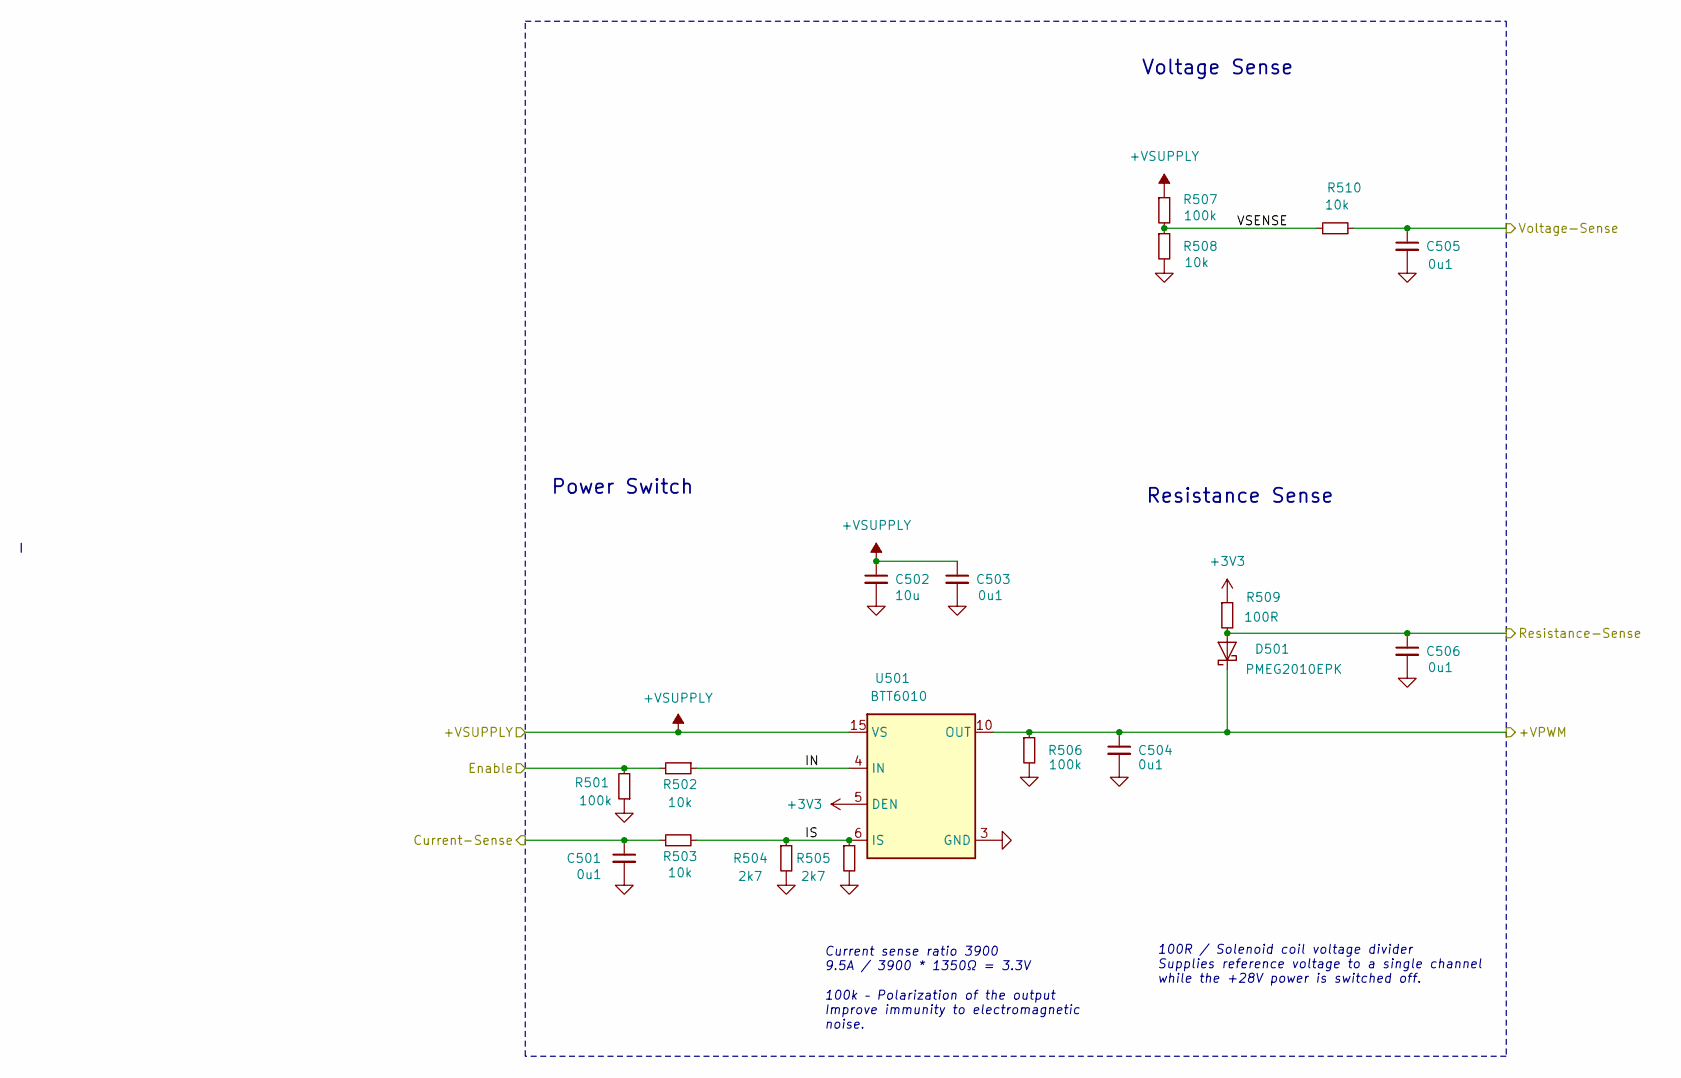
[picture p18: schematic Power-Switch.kicad_sch, V2 beat]

Parts:
C501, C503, C504, C505, C506: 0u1; C_1608; Rating 50V; Mouser 810-CGA3E2X7R1H104MA
C502: 10u; C_3225; Rating 50V; Mouser 810-CNC6P1X7R1H106K2
D501: PMEG2010EPK; D_SOD-1608; Rating 20V; Mouser 771-PMEG2010EPK
R501, R506, R507: 100k; R_1608; Rating 100mW; Mouser 71-CRCW0603100KFKEAC
R502, R503, R508, R510: 10k; R_1608; Rating 100mW; Mouser 71-CRCW060310K0FKEAC
R504, R505: 2k7; R_1608; Rating 100mW; Mouser 71-CRCW06032K70FKEAC
R509: 100R; R_1608; Rating 330mW; Mouser 71-CRCW0603100RFKEAH
U501: BTT6010; PG-TDS0-14; Rating 36V; Mouser 726-BTT60101ERBXUMA1

Connections:
+3V3: R509.1, U501.5 (DEN); also elsewhere on the board
/+VSUPPLY: C502.1, C503.1, R507.1, U501.15 (VS); also elsewhere on the board
/Current-Sense: C501.1, R503.1; also elsewhere on the board
/PWM/+VPWM: C504.1, D501.1 (K), R506.1, U501.10 (OUT), U501.11 (OUT), U501.12 (OUT); also elsewhere on the board
/PWM/PWM Power/IN: R502.1, U501.4 (IN)
/PWM/PWM Power/IS: R503.2, R504.1, R505.1, U501.6 (IS)
/PWM/PWM Power/VSENSE: R507.2, R508.1, R510.1
/Power-Enable: R501.2, R502.2; also elsewhere on the board
/Resistance-Sense: C506.1, D501.2 (A), R509.2; also elsewhere on the board
/Voltage-Sense: C505.1, R510.2; also elsewhere on the board
GND: C501.2, C502.2, C503.2, C504.2, C505.2, C506.2, R501.1, R504.2, R505.2, R506.2, R508.2, U501.3 (GND); also elsewhere on the board

Notes on the sheet:
100k – Polarization of the output Improve immunity to electromagnetic noise.
Current sense ratio 3900 9.5A / 3900 * 1350Ω = 3.3V
Voltage Sense
Power Switch
100R / Solenoid coil voltage divider Supplies reference voltage to a single channel while the +28V power is switched off.
Resistance Sense

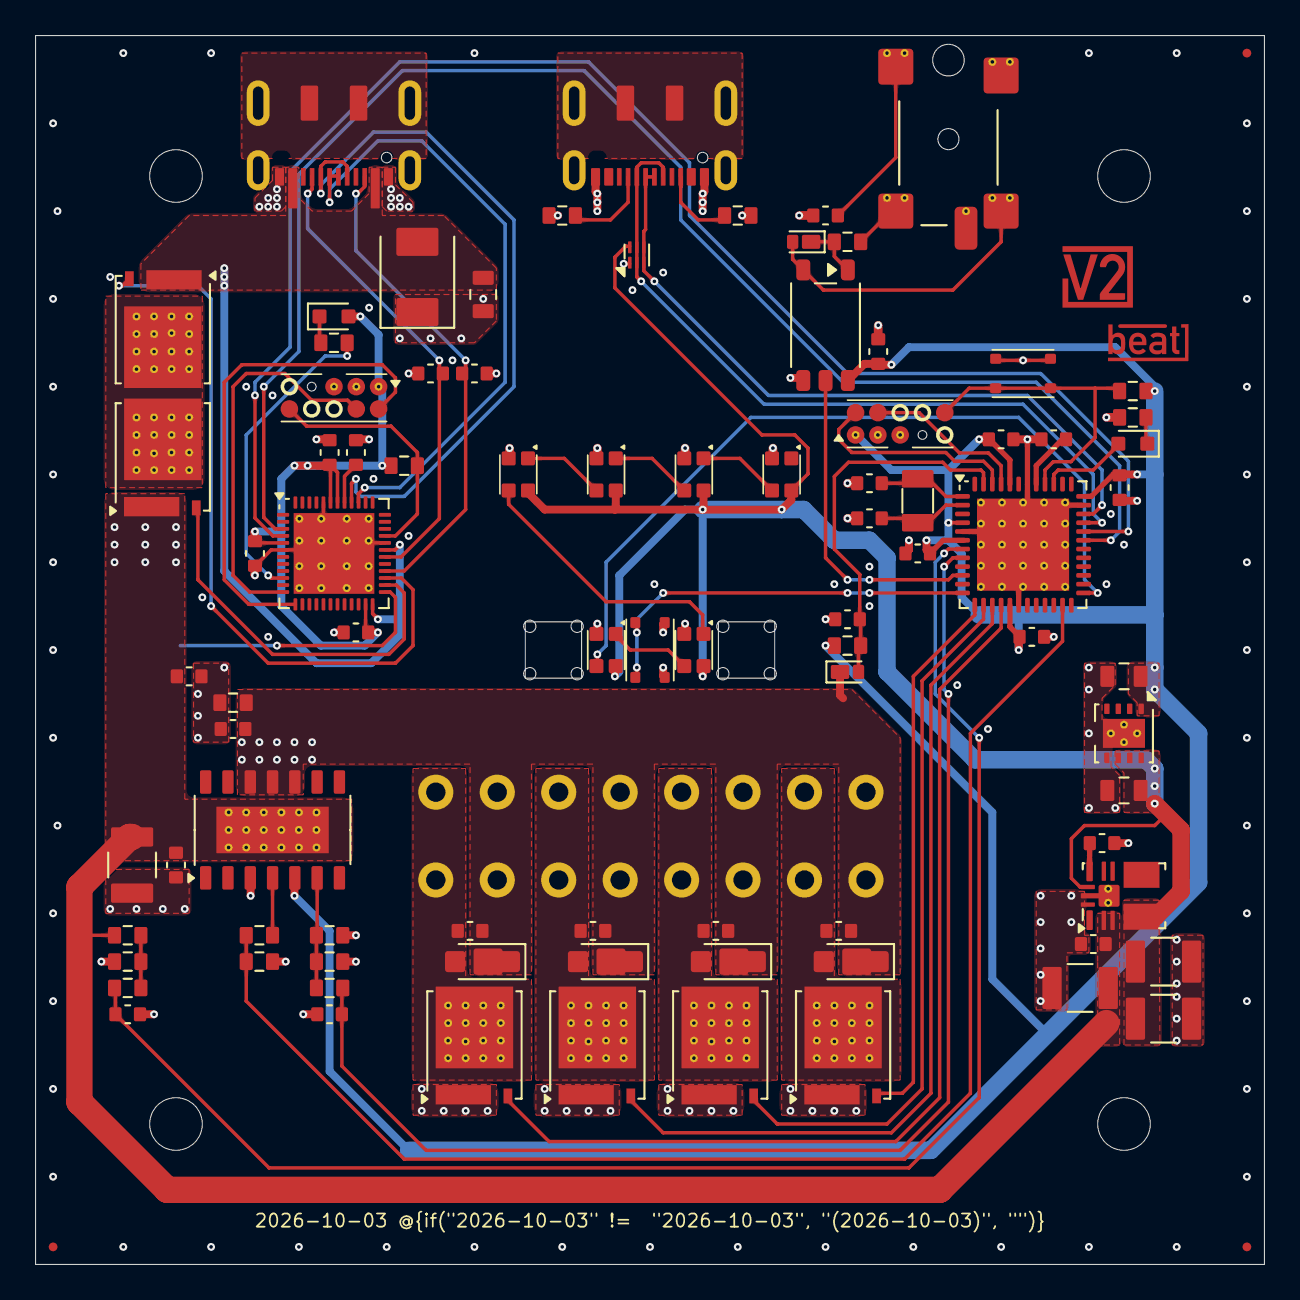
[picture p19: board beat-4.kicad_pcb from above]

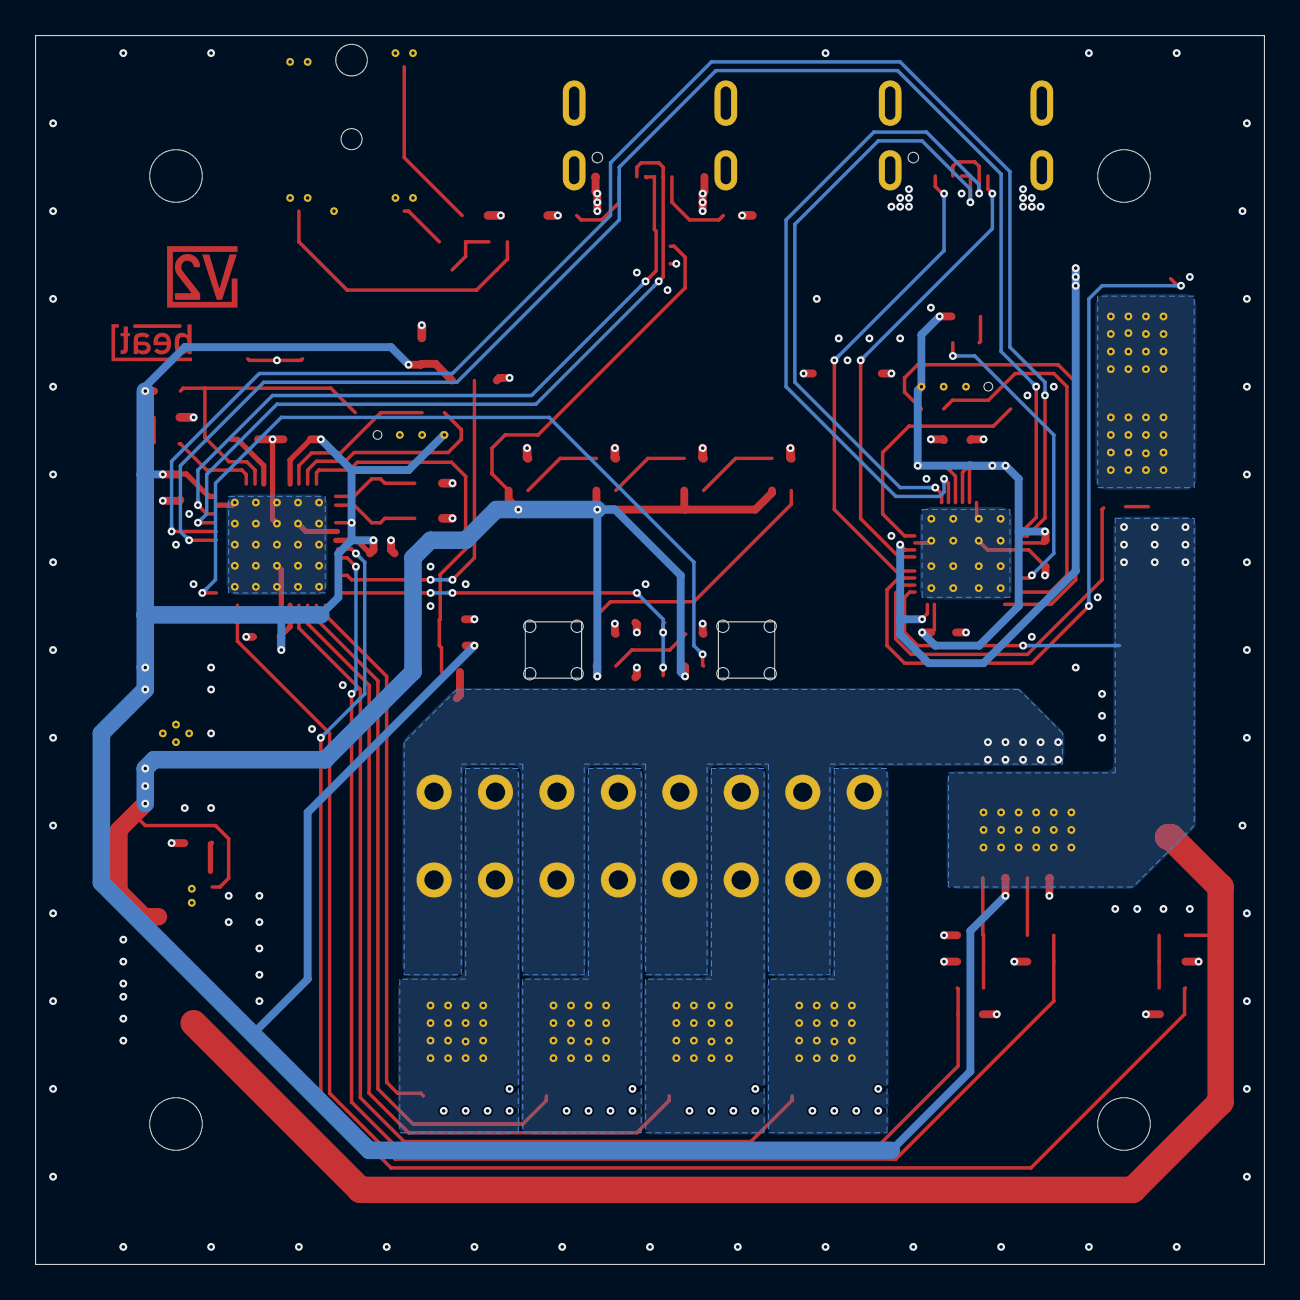
[picture p20: board beat-4.kicad_pcb from below]

Board: 4 copper layers, 70.0 x 70.0 mm, 107 parts (8 on the bottom side), 62 nets.
