versioduo/beat-4/(commit log)

2026-09-01 Move parts away from edge
    [MIDI-In.kicad_sch, PWM-Channel.kicad_sch, PWM.kicad_sch, Power-DCDC.kicad_sch, Power-Switch.kicad_sch, Power-USB.kicad_sch, beat-4.kicad_pcb, beat-4.kicad_sch]
2026-10-19 Update USB-PD SWD
    [MIDI-In.kicad_sch, PWM-Channel.kicad_sch, PWM.kicad_sch, Power-DCDC.kicad_sch, Power-Switch.kicad_sch, Power-USB.kicad_sch, back.kicad_pcb, back.kicad_sch]
